RU09342-F18/intro-to-embedded-final-project-saif/Spiral_Developent_Chart.png

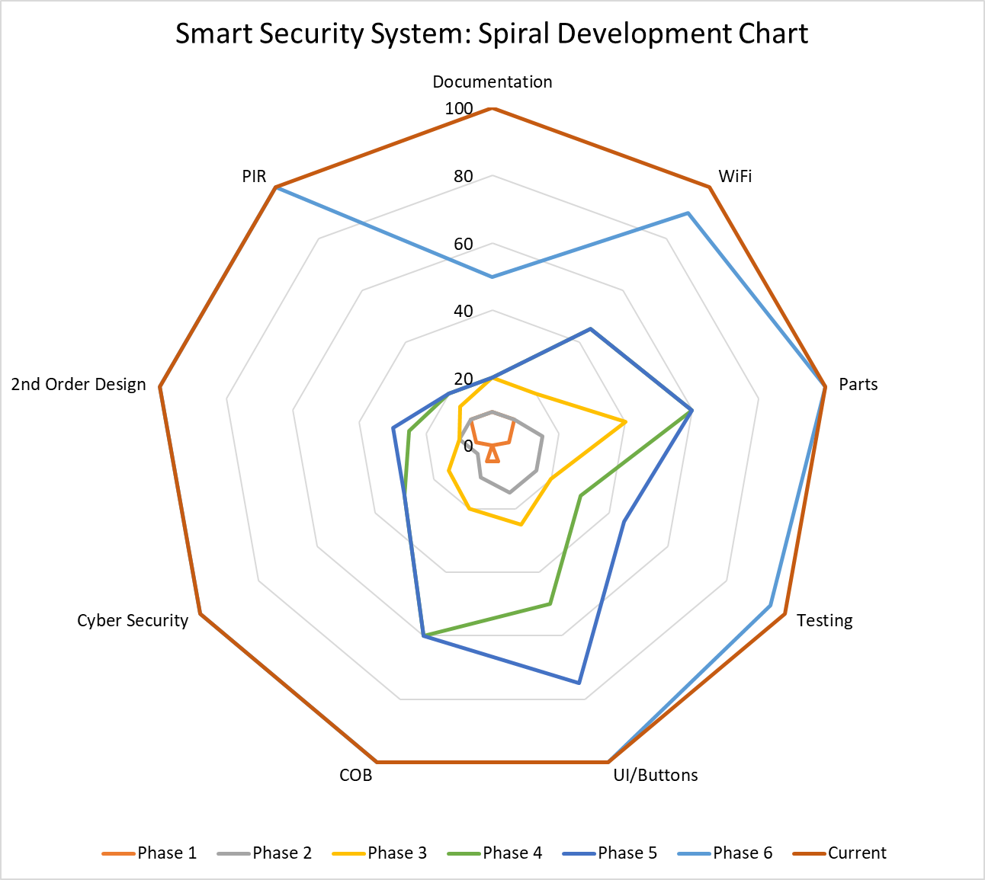
Spiral_Developent_Chart.png
