RU09342-F18/intro-to-embedded-final-project-saif/(list of files, drawings)

Other design files:
PCB_Files/SAIF_PCB.dip
