RU09342-F18/intro-to-embedded-final-project-saif/(commit log)

2018-12-18 Added timer for 10s buzzer; added "correct" light
    [main.c]
2018-12-18 improved uart usability
2018-12-19 added PCB files
    [SAIF_PCB.dip]
2018-12-19 renamed PCB Files folder
    [SAIF_PCB.dip]
2018-12-19 added schematic
